jwalthour/motordriver/hw/BOM.xls

Desc | Value | Datasheet | Buy link | Qty | Unit cost | Total cost | Notes
Microprocessor | Arduino | http://www.atmel.com/dyn/resources/prod_documents/8271S.pdf | http://www.adafruit.com/products/123 | 1 | $6.00 | $6.00
Motor Driver | 2x2A | http://www.st.com/internet/com/TECHNICAL_RESOURCES/TECHNICAL_LITERATURE/DATASHEET/CD00000240.pdf | http://search.digikey.com/scripts/DkSearch/dksus.dll?Detail&name=497-1395-5-ND | 3 | $4.67 | $14.01 | Sparkfun tends to sell these at a discount; check if it's worth the extra shipping for you https://www.sparkfun.com/products/9479
Inverter | 6x | http://focus.ti.com/lit/ds/symlink/sn74ls04.pdf | http://search.digikey.com/scripts/DkSearch/dksus.dll?Detail&name=296-1724-5-ND | 2 | $1.19 | $2.38
Poly fuse | 1.95A | http://www.littelfuse.com/data/en/Data_Sheets/Littelfuse_PTC_1812L.pdf | http://search.digikey.com/scripts/DkSearch/dksus.dll?Detail&name=F3486CT-ND | 6 | $0.60 | $3.60
Voltage regulator | 5V | http://www.diodes.com/datasheets/AP1117.pdf | http://search.digikey.com/scripts/DkSearch/dksus.dll?WT.z_header=search_go&lang=en&site=us&x=0&y=0 | 1 | $0.69 | $0.69
Diode | Fast recovery | http://www.diodes.com/datasheets/ds27001.pdf | http://search.digikey.com/scripts/DkSearch/dksus.dll?Detail&name=PR1007G-TDICT-ND | 24 | $0.34 | $8.11
Capacitor | 100uF | http://industrial.panasonic.com/www-cgi/jvcr13pz.cgi?E+PZ+3+ABA0012+ECA1EM101+7+WW | http://search.digikey.com/scripts/DkSearch/dksus.dll?WT.z_header=search_go&lang=en&site=us&x=0&y=0 | 1 | $0.25 | $0.25
Capacitor | 100nF | http://search.murata.co.jp/Ceramy/image/img/PDF/ENG/RPEF51H104Z2K1A03.pdf | http://search.digikey.com/scripts/DkSearch/dksus.dll?WT.z_header=search_go&lang=en&site=us&x=0&y=0 | 1 | $0.25 | $0.25
Header pins | 5pin | http://www.samtec.com/ftppub/pdf/TLW_TH.PDF | http://search.digikey.com/scripts/DkSearch/dksus.dll?Detail&name=SAM1099-05-ND | 1 | $1.07 | $1.07
Header pins | 3pin | http://www.samtec.com/ftppub/pdf/TLW_TH.PDF | http://search.digikey.com/scripts/DkSearch/dksus.dll?Detail&name=SAM1035-03-ND | 1 | $0.32 | $0.32
Terminal block | 2pin | http://www.on-shore.com/sites/default/files/manuals/osttcxx2162.pdf | http://search.digikey.com/scripts/DkSearch/dksus.dll?WT.z_header=search_go&lang=en&site=us&x=0&y=0 | 7 | $0.21 | $1.47
IC socket | 28pin | http://www.te.com/commerce/DocumentDelivery/DDEController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 | http://www.digikey.com/scripts/DkSearch/dksus.dll?WT.z_header=search_go&lang=en&x=0&y=0&cur=USD | 1 | $0.44 | $0.44
Resonator | 16MHz | http://www.ecsxtal.com/store/pdf/zttr.pdf | http://www.digikey.com/product-search/en/crystals-and-oscillators/resonators/852887?k=x908-ND | 1 | $0.70 | $0.70
Serial connector | 9pin D-sub female | http://www.te.com/commerce/DocumentDelivery/DDEController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 | http://www.digikey.com/product-detail/en/5-747905-4/A102039-ND/2262186 | 1 | $3.25 | $3.25 | This is a solder cup style connector; any style will do
Header receptacle | Female crimp pin | http://www.molex.com/elqNow/elqRedir.htm?ref=http://www.molex.com/pdm_docs/sd/986581211_sd.pdf | http://www.digikey.com/product-detail/en/0986581211/WM3979CT-ND/2421660 | 3 | $0.21 | $0.63 | 3 is minimum for the board to function. It's easy to screw these up so make sure you buy spares. Many variations on this are available; only one is listed here. It helps to have the right crimping tool but you could probably use pliers if you need.
Header shroud | 3pin | http://portal.fciconnect.com/Comergent//fci/drawing/65039.pdf | http://www.digikey.com/product-detail/en/65039-034LF/609-2340-ND/1002655 | 1 | $0.69 | $0.69 | If you pick a different female crimp pin make sure you pick one of these that's compatible
USB to serial converter |  |  | http://www.google.com/products/catalog?q=buy+usb+to+serial+converter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 | 1 | $10.00 | $10.00 | Any kind will do; this is what I used. The drivers did not seem to work on Windows but they worked on Xandros and Debian.
 |  |  |  |  | Total cost | $53.86
