jwalthour/motordriver/hw/driver_schematic.pdf

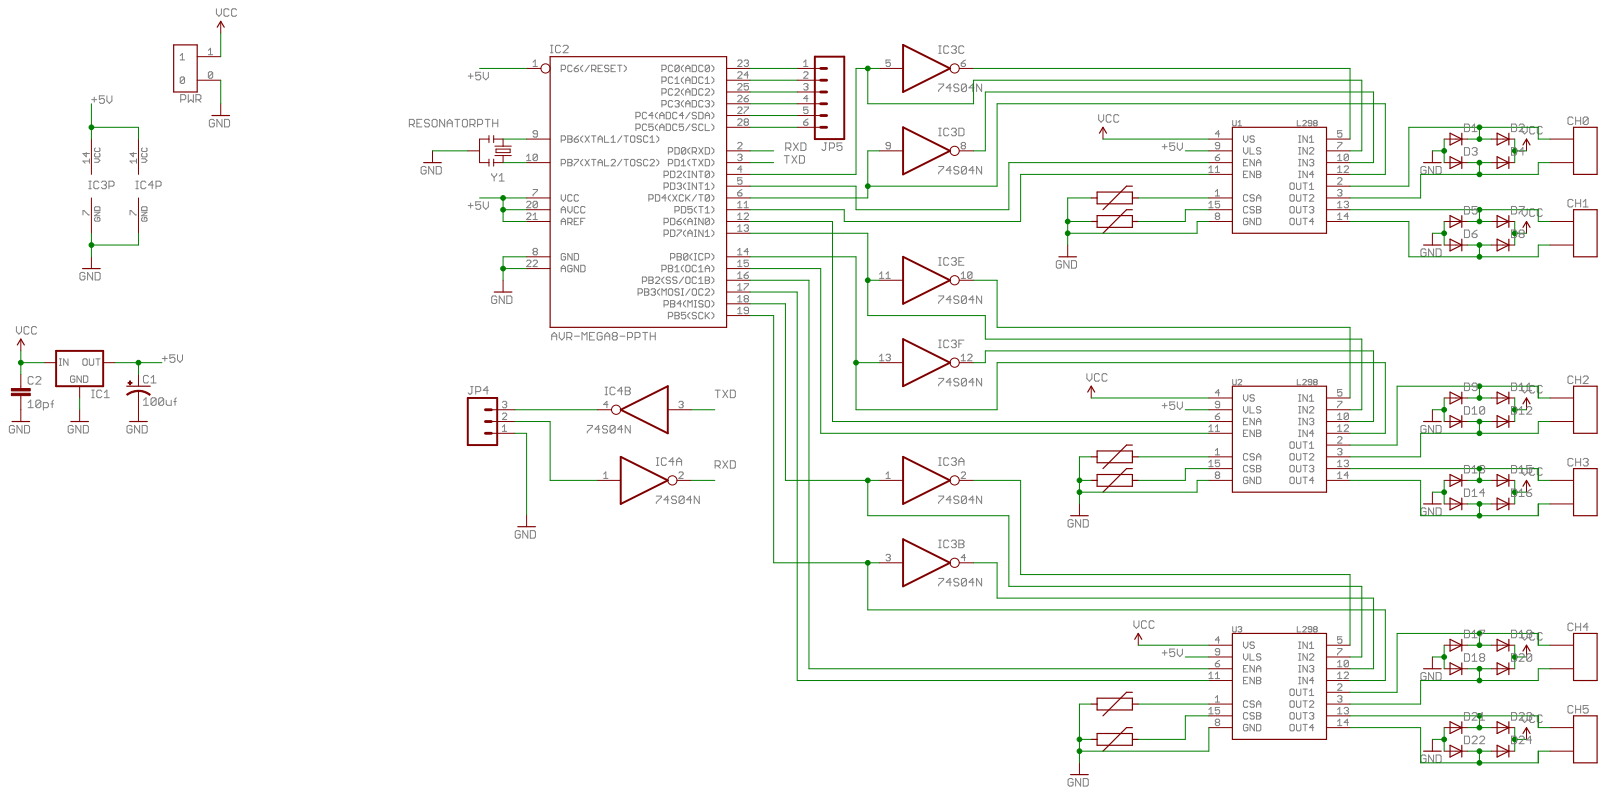
[picture p1: page 1]
