jwalthour/motordriver/hw/driver_board_all_layers.pdf

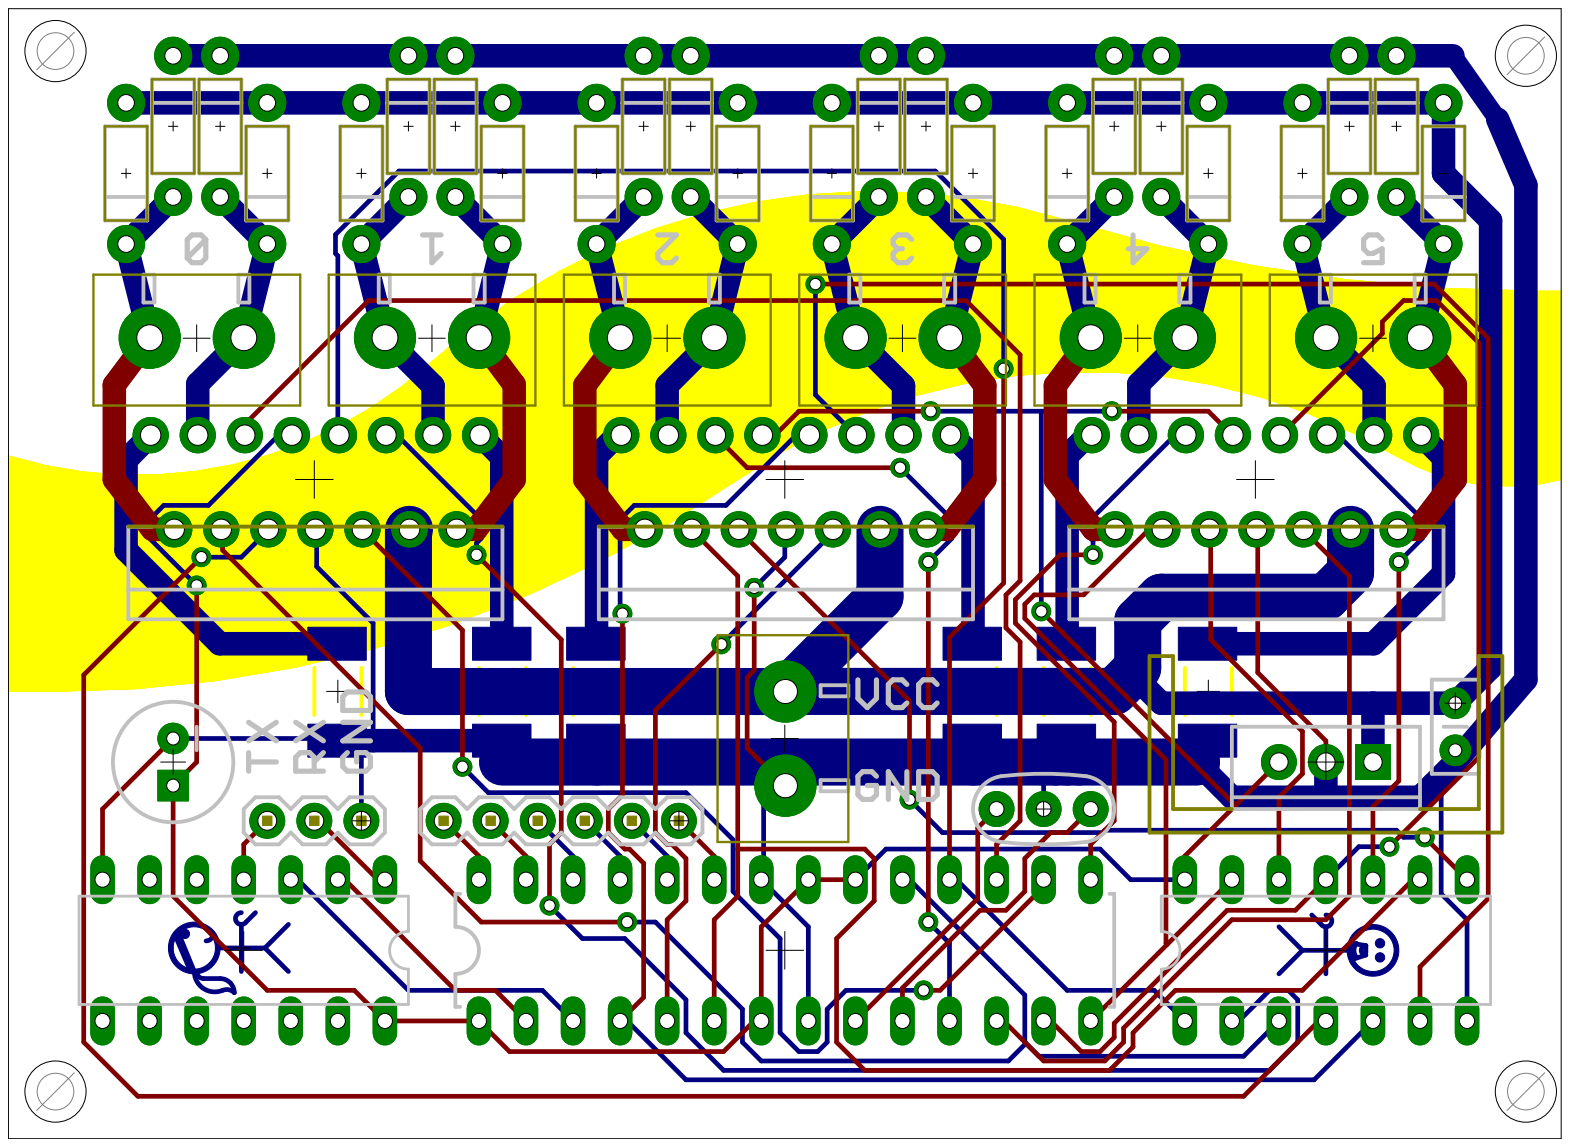
[picture p2: page 1]
